Qwerty-techlab/GB-T-DC-AC-inverter/README.md

 *Ошибки по схемотехнике:*

 	1\. Питание ADUM подключено к +12, **максимум +5В**.

 	2\. Затворный резистор сильно большой, надо взять значение из даташита, иначе фронты сильно длинные.

*Ошибки по плате:*

 	1\. посадочные под диоды мелкие, либо заказать диоды выпрямительные меньше.

 	2\. транзистор на стороне GBT разъема возле irlml перевернут зеркально, я подумал это тот же мосфет, но когда вспомнил что ошибся уже было поздно, из быстрого фикса отладки это впаять его вверх ногами.

 	3\. кондер на стороне dcdc блока питания надо перенести прямо под него, иначе не влезет радиатор.

*Мнение о плате драйвера EGS002:*

 	1\. не все платы как оказалось работают правильно, последняя не видит V_FB, посмотрев осциллографом, на ноге действительно меняется напряжение, но плата не реагирует. Соответственно скважность она регулирует и ставит на максимум.

 	2\. я бы разработал свой драйвер с выходной диаграммой как у частотников (там тот же pure - sine, но более логичный и задается не dU, а FPWM или сигма-дельта модуляция)

 	3\. общение по юарт возможно, но надо на плате перерезать дорожку до земляного полигона, и припаять провода (оба выхода по дефолту заземлены).

 	4\. общение по юарт не функционально, можно считать напряжение и ток, но в китайских попугаях, никакой точности нет. Из управления то же что и задается перемычками.

Ссылки на статьи: 

https://power-e.ru/wp-content/uploads/2011_1_50.pdf
