Qwerty-techlab/GB-T-DC-AC-inverter/Спецификация  V1.0.xlsx

Микросхемы аналоговые
Количество | парт номер | комментарий | посадочное | designator | ссылка
1 | B0505S-1WR3 | dc/dc morsun | SIP4 | DA1
1 | ISO1050DUBR |  | ISO1050 | DA2
1 | ADuM1201 | изолятор двунаправленный 2 канала | SO-8 | DA3
1 | L78M05CV | ldo 5v | TO-220 | DA7
1 | AMS1117 |  | SOT229 | U2
1 | XL6009 | The XL6009 regulator is a wide input range, current mode, DC/DC converter which is capable of generating either positive or negative output voltages. |  | VR1
1 | MT3608 | Повышающий DC-DC преобразователь 28В 2А 1.2МГц | SOT23-6 | DA5
1 | TP4056 | Complete single cell Li-Ion battery with a constant current / constant voltage linear charger | ESOP-8 | U1
Микросхемы цифровые
Количество | парт номер | комментарий | посадочное | designator | ссылка
1 | STM32F407VET6 |  | LQFP100 | DA4
Транзисторы
Количество | парт номер | комментарий | посадочное | designator | ссылка
4 | SGT40N60FD2PN | IGBT, можно любой 40N60 | TO-247 | VT5, VT6, VT7, VT8
4 | IRLML6244 | n-mos | SOT23 | VT1, VT2, VT3, Q3
1 | BC857BS,115 | 2 npn | SOT-363 | Q1
1 |  |  |  | Q2
Диоды
Количество | парт номер | комментарий | посадочное | designator | ссылка
1 | PESD1CAN,215 |  | SOT23_M | D1
2 | SS34 | Schottky | SMB | D5, D6
2 | 1N5819HW-7-F | Schottky | SOD-123 | D2, D3 | https://www.chipdip.ru/product/1n5819hw-7-f-diodes-8791354983
6 | S1M-E3/61T | диод выпрямительный | SMA | VD1, VD6, VD2, VD3, VD4, VD5 | https://www.chipdip.ru/product/s1m-e3-61t-vishay-8390836973
Резисторы
Количество | парт номер | комментарий | посадочное | designator | ссылка
1 | RC0805FR-07120RL | 120 Ом | 0805 | R11 | https://www.chipdip.ru/product/0.125vt-0805-120-om-1-rc0805fr-07120rl-chip-rezistor-yageo-9000174442
5 | RC0805FR-07330RL | 330 Ом | 0805 | R1, R4, R5, R8, R9 | https://www.chipdip.ru/product/0.125vt-0805-330-om-1-rc0805fr-07330rl-chip-rezistor-yageo-9000321160
6 | RC1206FR-0733K2L | 33.2kOm | 1206 | R16, R17, R18, R19, R20, R21 | https://www.chipdip.ru/product/rc1206fr-0733k2l-yageo-8010306788?from=suggest_product
9 | RC0805FR-074K7L | 4k7 | 0805 | R6, R26, R32, R43, R44, R34, R35, R39, R38 | https://www.chipdip.ru/product/0.125vt-0805-4.7-kom-1-rc0805fr-074k7l-chip-rezistor-yageo-9000350078
10 | RC0805FR-0710KL | 10k | 0805 | R10, R12, R13, R27, R36, R37, R41, R40, R3, R2 | https://www.chipdip.ru/product/0.125vt-0805-10-kom-1-rc0805fr-0710kl-chip-rezistor-yageo-9000272499
2 | RESCAV80P320X160X70-8N |  |  | RN1, RN2
2 | RC0805FR-0747KL | 47k | 0805 | R29, R33 | https://www.chipdip.ru/product/0.125vt-0805-47-kom-1-rc0805fr-0747kl-chip-rezistor-yageo-9001194464
1 | RC0805FR-07510RL | 510Om | 0805 | R7 | https://www.chipdip.ru/product/0.125vt-0805-510-om-1-rc0805fr-07510rl-chip-rezistor-yageo-9000493317
2 | RC0805JR-071K1L | 1,1kOm | 0805 | R49, R50, | https://www.chipdip.ru/product/0.125vt-0805-1.1-kom-5-rc0805jr-071k1l-chip-rezistor-yageo-9000172311
2 | AC0805FR-071KL | 1kOm | 0805 | R46, R45 | https://www.chipdip.ru/product/0.125vt-0805-1-kom-ac0805fr-071kl-chip-rezistor-smd-yageo-9000881292
1 | RC0805FR-076K8L | 6,8kOm | 0805 | R48
1 | RC0805JR-078K2L | 8,2kOm | 0805 | R47 | https://www.chipdip.ru/product/0.125vt-0805-8.2-kom-5-rc0805jr-078k2l-chip-rezistor-yageo-9000477996
2 | 0.8x10mm 200mR 5pcs | шунт 0.2 Ом (2 в параллель) |  | R42 | https://aliexpress.ru/item/1005006966034372.html?sku_id=12000038952718128
2 |  | резисторы подбираются эксперементально | 1206 | R23, R28
Конденсаторы
Количество | парт номер | комментарий | посадочное | designator | ссылка
1 | GRM21BR72E103KW03L | 0.01uF | 0805 | C6 | https://www.chipdip.ru/product/0.01-mkf-250v-x7r-10-0805-10nf-grm21br72e103k-murata-796205664
3 | GRM21BR71H104KA01L | 0.1uF | 0805 | C7, C2, C5 | https://www.chipdip.ru/product/0.1-mkf-x7r-50v-10-0805-grm21br71h104ka01l-murata-860640216
1 | GRM31MR71H105KA88L | 1uF | 1206 | C24 | https://www.chipdip.ru/product/1-mkf-x7r-50v-10-1206-grm31mr71h105k-kondensator-murata-9000062095
15 | GRM21BR61H106KE43L | 10uF | 1206 | C1, C4, C28, C27, C13. C14, C18, C19, C20, C21, C26, C23, C16, C25. C29 | https://www.chipdip.ru/product/10mkf-x5r-50v-10-0805-grm21br61h106ke43l-kondensator-murata-9000665990
2 | 293D476X9025D2TE3 | 47uF 25V | SMDD | C15, С31 | https://www.chipdip.ru/product/tecap-47mkf-25v-tip-d-10-293d476x9025d2te3-vishay-9001567685
2 | 293D107X9016D2TE3 | 100uF 16V | SMDD | C17, C30 | https://www.chipdip.ru/product/tecap-100mkf-16v-tip-d-10-293d107x9016d2te3-vishay-9001567692
3 | 126RV0004 | 220uF 50V | ecap D10 | C22, C9, C8 | https://www.chipdip.ru/product/126rv0004-220uf-50v-220ma-120hz-20-smd-d10xl10.5mm-knscha-8017157223
2 | CC0805JRNPO9BN300 | 30pF | 0805 | C11, C12 | https://www.chipdip.ru/product/30pf-np0-50v-5-0805-cc0805jrnpo9bn300-kondensator-yageo-9000607125
1 | TAJA226K010RNJ | 22uF | SMDA | C3
1 | B32776G4306K000 | 30мкФ нету в ТЭ |  | C10 | https://www.chipdip.ru/product/b32776g4306k000-film-capacitors-30uf-10-450v-cap-mkp-epcos-8005380186
Индуктивность
Количество | парт номер | комментарий | посадочное | designator | ссылка
1 | CDRH127NP-330MC | 33uH |  | L2 | https://www.chipdip.ru/product/cdrh127np-330mc-sumida-8001781068
1 |  | хз че за дроссель, в даташите 4.7-22мкГн, на схеме 470мГн размером 7х7 мм | MT3608 IND | L3 |  | 22мкГн поставил
Разъемы
Количество | парт номер | комментарий | посадочное | designator | ссылка
2 | FBFS008 | CQ-216, 10х38мм, Держатель предохранителя на плату |  | F1 | https://www.chipdip.ru/product/cq-216-10x38mm-derzhatel-predohranitelya-na-platu-9000557568
2 | DG950 X2 - 2 |  |  | X3, X4
5 | CWF-2 |  |  | X1, X2, X7, XS1, XS4
2 | CWF-4 |  |  | XS3, XS6,
1 | PLS-4 (DS-1021-1x4) |  |  | XS5
1 | CWF-6 |  |  | XS*1
1 | CWF-10 |  |  | XS2
Прочее
Количество | парт номер | комментарий | посадочное | designator | ссылка
1 | HUXUAN 10x38 мм 20A | на али |  | F1 | https://aliexpress.ru/item/1005006216076359.html?sku_id=12000036318802970
1 | G2RL1E24DC | relay |  | K1
1 | HC-49S | резонатор кварцевый | HC-49S | ZQ1
1 | VRB_ZP-6WR3 | блок питния dc-dc |  | T1
Заказать
Количество | парт номер | комментарий | посадочное | designator | ссылка
1 | HUXUAN 10x38 мм 20A | на али |  | F1 | https://aliexpress.ru/item/1005006216076359.html?sku_id=12000036318802970
1 | VRB_ZP-6WR3 | блок питния dc-dc 12-12В |  | T1
2 | FBFS008 | CQ-216, 10х38мм, Держатель предохранителя на плату |  | F1 | https://www.chipdip.ru/product/cq-216-10x38mm-derzhatel-predohranitelya-na-platu-9000557568
1 | B32776G4306K000 | 30мкФ нету в ТЭ |  | C10 | https://www.chipdip.ru/product/b32776g4306k000-film-capacitors-30uf-10-450v-cap-mkp-epcos-8005380186
2 | 0.8x10mm 200mR 5pcs | шунт 0.2 Ом (2 в параллель) |  | R42 | https://aliexpress.ru/item/1005006966034372.html?sku_id=12000038952718128
4 | SGT40N60FD2PN | IGBT, можно любой 40N60 | TO-247 | VT5, VT6, VT7, VT8
1 | L78M05CV | ldo 5v | TO-220 | DA7
