Qwerty-techlab/GB-T-DC-AC-inverter/dc-ac.step

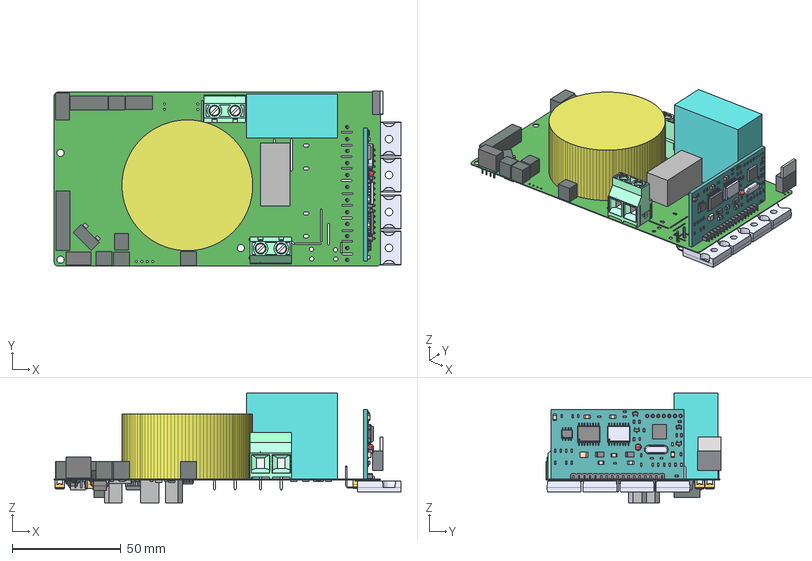
[picture p1: CAD file, 2026-09-26]
dc-ac.step
159.3 x 80.5 x 50.4 mm
Board
Extruded x 103
X_7343-43 x 16
C29
C28
SOIC-8_3.9x4.9mm_P1.27mm
C27
C1
C4
C13
C14
C16
C18
C19
C20
C21
C23
C24
C25
C26
D2
D3
SS24--3DModel-STEP-56544 x 2
SIP4
ISO1050DUB
TO-247H x 20
DG950-9.5-02P-14-00AH x 2
