Qwerty-techlab/GB-T-DC-AC-inverter/(list of files, drawings)

Other design files:
DC-AC.PrjPcb
Driver.SchDoc
Main.SchDoc
PCB1.PcbDoc
